zjuelma/Proj/(list of files, cad)

Other CAD files:
Objects/main.obj
Objects/LCD1602.obj
Objects/delay.obj
Objects/MLX90614.obj
